nelgau/breakout-pcbs/FT2232H_USB-C_to_2x10_1.27_F_RA/FT2232H_USB-C_to_2x10_1.27_F_RA.kicad_pcb

## KiCad design FT2232H_USB-C_to_2x10_1.27_F_RA/FT2232H_USB-C_to_2x10_1.27_F_RA.kicad_pcb (2020-09-25)

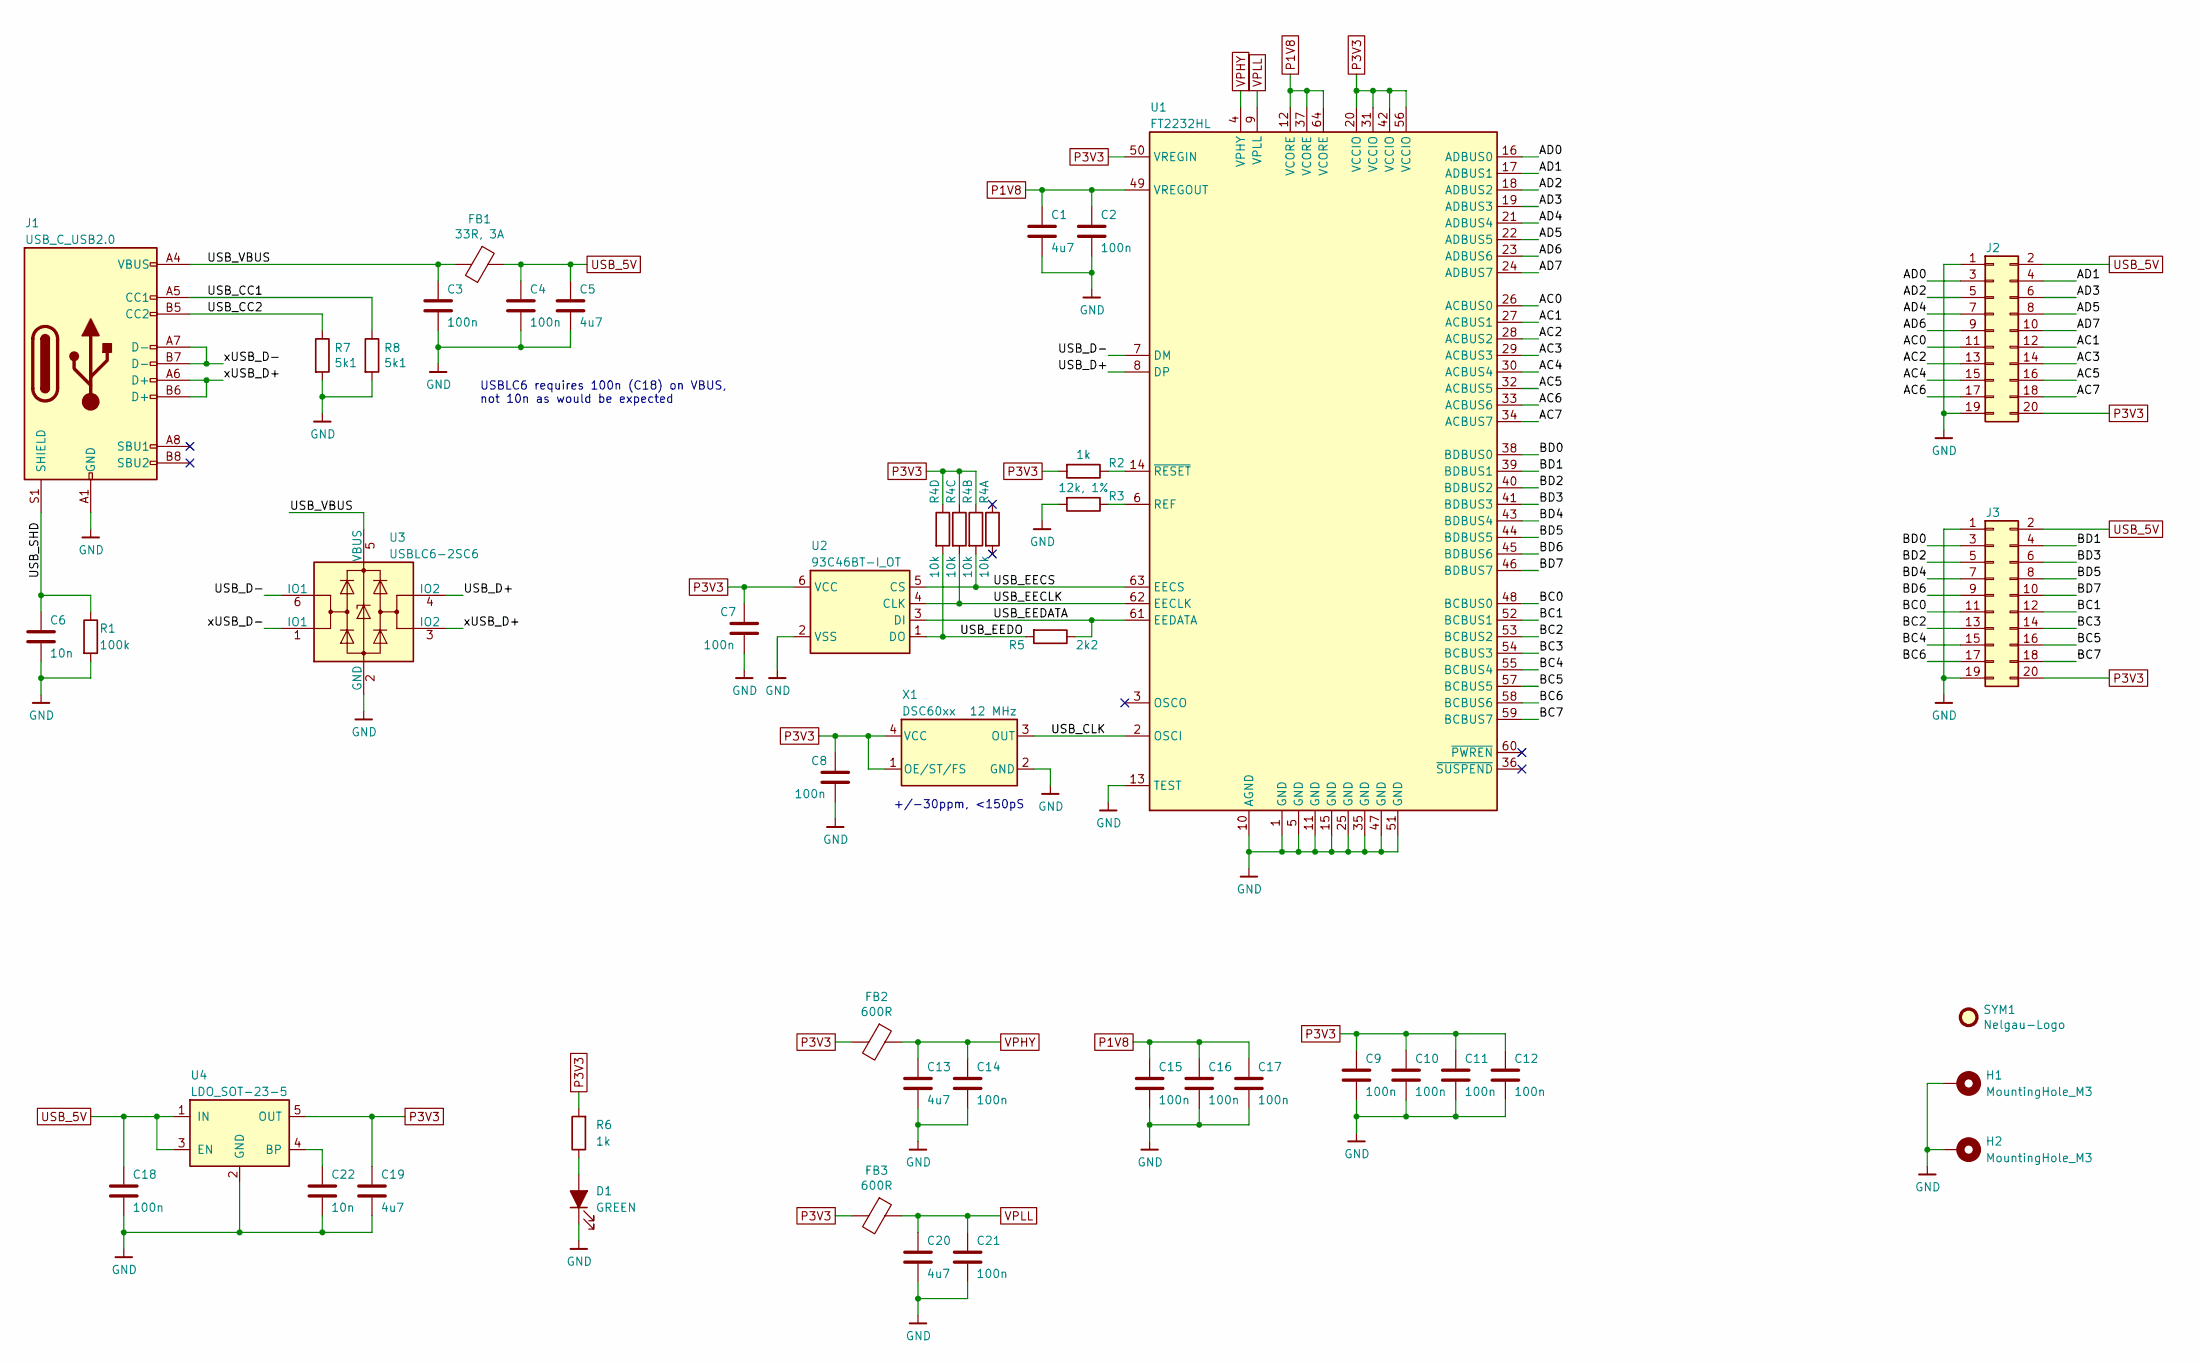
[picture p1: schematic FT2232H_USB-C_to_2x10_1.27_F_RA.sch]

Parts:
C1, C5, C13, C19, C20: 4u7; C_0603_1608Metric
C2, C3, C4, C7, C8, C9, C10, C11, C12, C14, C15, C16, C17, C18, C21: 100n; C_0603_1608Metric
C6, C22: 10n; C_0603_1608Metric
D1: GREEN; LED_0603_1608Metric
FB1: 33R, 3A; L_0603_1608Metric; MPN BLM18PG330SN1D
FB2, FB3: 600R; L_0603_1608Metric
H1, H2: MountingHole_M3; MountingHole_3.2mm_M3_Pad_Via
J1: USB_C_USB2.0; USB_C_Receptacle_HRO_TYPE-C-31-M-12
J2, J3: Conn_02x10_Odd_Even; PinSocket_2x10_P2.54mm_Horizontal
R1: 100k; R_0603_1608Metric; MPN RC0603JR-07100KL
R2, R6: 1k; R_0603_1608Metric
R3: 12k, 1%; R_0603_1608Metric
R4: 10k; R_Array_Convex_4x0603; MPN YC164-JR-0710KL
R5: 2k2; R_0603_1608Metric
R7, R8: 5k1; R_0603_1608Metric
SYM1: Nelgau-Logo; Nelgau-Logo_5.2x1.7mm_SilkScreen
U1: FT2232HL; LQFP-64_10x10mm_P0.5mm
U2: 93C46BT-I_OT; SOT-23-6
U3: USBLC6-2SC6; SOT-23-6
U4: LDO_SOT-23-5; SOT-23-5
X1: DSC60xx; Oscillator_2.5x2.0

Connections:
/AC0: J2.11, U1.26 (ACBUS0)
/AC1: J2.12, U1.27 (ACBUS1)
/AC2: J2.13, U1.28 (ACBUS2)
/AC3: J2.14, U1.29 (ACBUS3)
/AC4: J2.15, U1.30 (ACBUS4)
/AC5: J2.16, U1.32 (ACBUS5)
/AC6: J2.17, U1.33 (ACBUS6)
/AC7: J2.18, U1.34 (ACBUS7)
/AD0: J2.3, U1.16 (ADBUS0)
/AD1: J2.4, U1.17 (ADBUS1)
/AD2: J2.5, U1.18 (ADBUS2)
/AD3: J2.6, U1.19 (ADBUS3)
/AD4: J2.7, U1.21 (ADBUS4)
/AD5: J2.8, U1.22 (ADBUS5)
/AD6: J2.9, U1.23 (ADBUS6)
/AD7: J2.10, U1.24 (ADBUS7)
/BC0: J3.11, U1.48 (BCBUS0)
/BC1: J3.12, U1.52 (BCBUS1)
/BC2: J3.13, U1.53 (BCBUS2)
/BC3: J3.14, U1.54 (BCBUS3)
/BC4: J3.15, U1.55 (BCBUS4)
/BC5: J3.16, U1.57 (BCBUS5)
/BC6: J3.17, U1.58 (BCBUS6)
/BC7: J3.18, U1.59 (BCBUS7)
/BD0: J3.3, U1.38 (BDBUS0)
/BD1: J3.4, U1.39 (BDBUS1)
/BD2: J3.5, U1.40 (BDBUS2)
/BD3: J3.6, U1.41 (BDBUS3)
/BD4: J3.7, U1.43 (BDBUS4)
/BD5: J3.8, U1.44 (BDBUS5)
/BD6: J3.9, U1.45 (BDBUS6)
/BD7: J3.10, U1.46 (BDBUS7)
/USB_CC1: J1.A5 (CC1), R8.1
/USB_CC2: J1.B5 (CC2), R7.1
/USB_CLK: U1.2 (OSCI), X1.3 (OUT)
/USB_D+: U1.8 (DP), U3.4 (IO2)
/USB_D-: U1.7 (DM), U3.6 (IO1)
/USB_EECLK: R4.3, U1.62 (EECLK), U2.4 (CLK)
/USB_EECS: R4.2, U1.63 (EECS), U2.5 (CS)
/USB_EEDATA: R5.1, U1.61 (EEDATA), U2.3 (DI)
/USB_EEDO: R4.4, R5.2, U2.1 (DO)
/USB_SHD: C6.1, J1.S1 (SHIELD), R1.1
/USB_VBUS: C3.1, FB1.2, J1.A4 (VBUS), J1.A9 (VBUS), J1.B4 (VBUS), J1.B9 (VBUS), U3.5 (VBUS)
/xUSB_D+: J1.A6 (D+), J1.B6 (D+), U3.3 (IO2)
/xUSB_D-: J1.A7 (D-), J1.B7 (D-), U3.1 (IO1)
GND: C1.2, C2.2, C3.2, C4.2, C5.2, C6.2, C7.2, C8.2, C9.2, C10.2, C11.2, C12.2, C13.2, C14.2, C15.2, C16.2, C17.2, C18.2, C19.2, C20.2, C21.2, C22.2, D1.1 (K), H1.1, H2.1, J1.A1 (GND), J1.A12 (GND), J1.B1 (GND), J1.B12 (GND), J2.1, J2.19, J3.1, J3.19, R1.2, R3.2, R7.2, R8.2, U1.1 (GND), U1.5 (GND), U1.10 (AGND), U1.11 (GND), U1.13 (TEST), U1.15 (GND), U1.25 (GND), U1.35 (GND), U1.47 (GND), U1.51 (GND), U2.2 (VSS), U3.2 (GND), U4.2 (GND), X1.2 (GND)
unnamed: C22.1, U4.4 (BP)
unnamed: D1.2 (A), R6.1
unnamed: R2.1, U1.14 (~RESET)
unnamed: R3.1, U1.6 (REF)
P1V8: C1.1, C2.1, C15.1, C16.1, C17.1, U1.12 (VCORE), U1.37 (VCORE), U1.49 (VREGOUT), U1.64 (VCORE)
P3V3: C7.1, C8.1, C9.1, C10.1, C11.1, C12.1, C19.1, FB2.2, FB3.2, J2.20, J3.20, R2.2, R4.5, R4.6, R4.7, R6.2, U1.20 (VCCIO), U1.31 (VCCIO), U1.42 (VCCIO), U1.50 (VREGIN), U1.56 (VCCIO), U2.6 (VCC), U4.5 (OUT), X1.1 (OE/ST/FS), X1.4 (VCC)
USB_5V: C4.1, C5.1, C18.1, FB1.1, J2.2, J3.2, U4.1 (IN), U4.3 (EN)
VPHY: C13.1, C14.1, FB2.1, U1.4 (VPHY)
VPLL: C20.1, C21.1, FB3.1, U1.9 (VPLL)

Notes on the sheet:
USBLC6 requires 100n (C18) on VBUS, not 10n as would be expected
+/-30ppm, <150pS

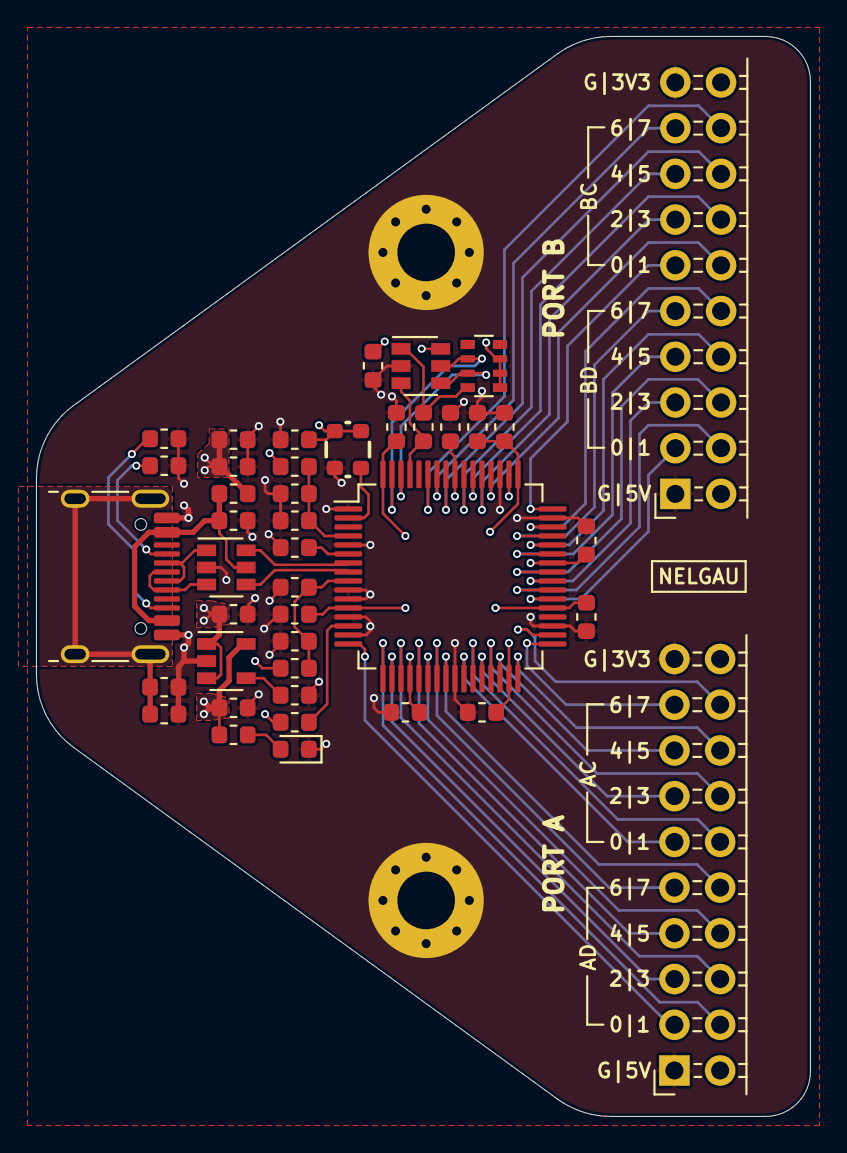
[picture p2: board FT2232H_USB-C_to_2x10_1.27_F_RA.kicad_pcb from above]

Board: 4 copper layers, 43.0 x 60.0 mm, 45 parts (0 on the bottom side), 55 nets.
