nelgau/breakout-pcbs/(commit log)

2020-06-23 Added personal KiCad libraries as a submodule lib/nelgau
2020-06-23 Add typical KiCad .gitignore
2020-06-23 Adapter board, 2x5 P2.54mm F RA to P1.27mm M, for JTAG, SWD, Lattice ISP programming interface
    [header_2x5_2.54_F_RA_to_1.27_M.kicad_pcb, header_2x5_2.54_F_RA_to_1.27_M.sch]
2020-06-23 [lib][ftp] Add variant of 2x5 2.54mm RA header without overhanging silkscreen
2020-06-23 Add 'header_2x5_2.54_F_RA_to_1.27_M' adapter board
    [header_2x5_2.54_F_RA_to_1.27_M.kicad_pcb, header_2x5_2.54_F_RA_to_1.27_M.sch]
2020-06-25 Update FTSH footprint with polarity mark
    [header_2x5_2.54_F_RA_to_1.27_M.kicad_pcb]
2020-07-08 Progress towards 2x5 P2.54mm F RA to P1.27mm M
    [header_2x5_2.54_F_RA_to_1.27_M.kicad_pcb]
2020-07-09 Create FT2232H_USB-C_to_2x10_1.27_F_RA breakout project
    [FT2232H_USB-C_to_2x10_1.27_F_RA.kicad_pcb, FT2232H_USB-C_to_2x10_1.27_F_RA.sch]
2020-07-21 Import old ice-programmer design into FT2232H_USB-C breakout
    [FT2232H_USB-C_to_2x10_1.27_F_RA.sch]
2020-07-21 Initial placement for FT2232H_USB-C
    [FT2232H_USB-C_to_2x10_1.27_F_RA.kicad_pcb, FT2232H_USB-C_to_2x10_1.27_F_RA.sch]
2020-07-22 Adjusting placement for FT2232_USB-C
    [FT2232H_USB-C_to_2x10_1.27_F_RA.kicad_pcb, FT2232H_USB-C_to_2x10_1.27_F_RA.sch]
2020-07-22 Add Nelgau-Logo to FT2232H_USB-C
    [FT2232H_USB-C_to_2x10_1.27_F_RA.kicad_pcb, FT2232H_USB-C_to_2x10_1.27_F_RA.sch]
2020-07-23 Routed all dense nets near FT2232H
    [FT2232H_USB-C_to_2x10_1.27_F_RA.kicad_pcb]
2020-07-23 Add tentative board edge and trim pin socket footprints
    [FT2232H_USB-C_to_2x10_1.27_F_RA.kicad_pcb, FT2232H_USB-C_to_2x10_1.27_F_RA.sch]
2020-07-24 Set final pin socket clearance
    [FT2232H_USB-C_to_2x10_1.27_F_RA.kicad_pcb]
2020-07-24 Clean up layout around FT2232H
    [FT2232H_USB-C_to_2x10_1.27_F_RA.kicad_pcb]
2020-07-24 Rough routing of data and control output buses
    [FT2232H_USB-C_to_2x10_1.27_F_RA.kicad_pcb]
2020-07-24 Finish routing data and control buses
    [FT2232H_USB-C_to_2x10_1.27_F_RA.kicad_pcb]
2020-07-24 Rough in the board edge with arcs
    [FT2232H_USB-C_to_2x10_1.27_F_RA.kicad_pcb]
2020-07-25 Use USB-C connector instead of micro-USB
    [FT2232H_USB-C_to_2x10_1.27_F_RA.kicad_pcb, FT2232H_USB-C_to_2x10_1.27_F_RA.sch]
2020-07-25 Reduce via usage on FT2232 ground connections
    [FT2232H_USB-C_to_2x10_1.27_F_RA.kicad_pcb]
2020-07-25 Fix collision between power trace and mouting hole pad
    [FT2232H_USB-C_to_2x10_1.27_F_RA.kicad_pcb]
2020-07-25 Implement option to use LDO with bypass capacitor
    [FT2232H_USB-C_to_2x10_1.27_F_RA.kicad_pcb, FT2232H_USB-C_to_2x10_1.27_F_RA.sch]
2020-07-26 Simplify routing of USB 2.0 data lines
    [FT2232H_USB-C_to_2x10_1.27_F_RA.kicad_pcb]
2020-07-26 Correct misrouted trace within USB interface
    [FT2232H_USB-C_to_2x10_1.27_F_RA.kicad_pcb]
2020-08-15 Poor copper zones and run final DRC checks
    [FT2232H_USB-C_to_2x10_1.27_F_RA.sch]
2020-09-25 Fix solder mask clearance/minimum width and reexport gerbers
    [FT2232H_USB-C_to_2x10_1.27_F_RA-B_Cu.gbr, FT2232H_USB-C_to_2x10_1.27_F_RA-B_Mask.gbr, FT2232H_USB-C_to_2x10_1.27_F_RA-B_Paste.gbr, FT2232H_USB-C_to_2x10_1.27_F_RA-B_SilkS.gbr, FT2232H_USB-C_to_2x10_1.27_F_RA-Edge_Cuts.gbr, FT2232H_USB-C_to_2x10_1.27_F_RA-F_Cu.gbr, FT2232H_USB-C_to_2x10_1.27_F_RA-F_Mask.gbr, FT2232H_USB-C_to_2x10_1.27_F_RA-F_Paste.gbr]
